TaylorSmith28/IQ_SDR/images/Schematics/SDR OPamp Power Supply.png

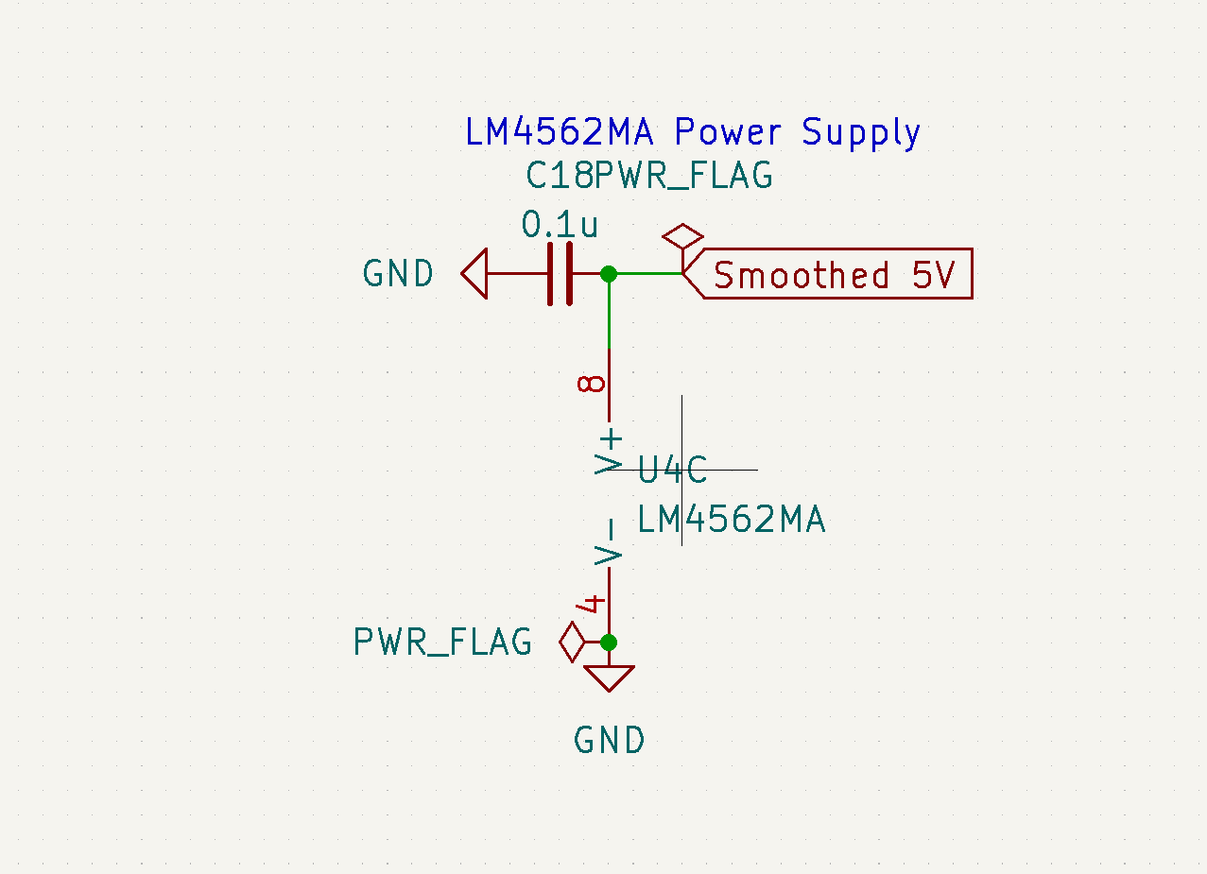
images/Schematics/SDR OPamp Power Supply.png
