TaylorSmith28/IQ_SDR/Kicad V6/Receiver Schematic.kicad_pcb

## KiCad design Kicad V6/Receiver Schematic.kicad_pcb (2022-06-07)

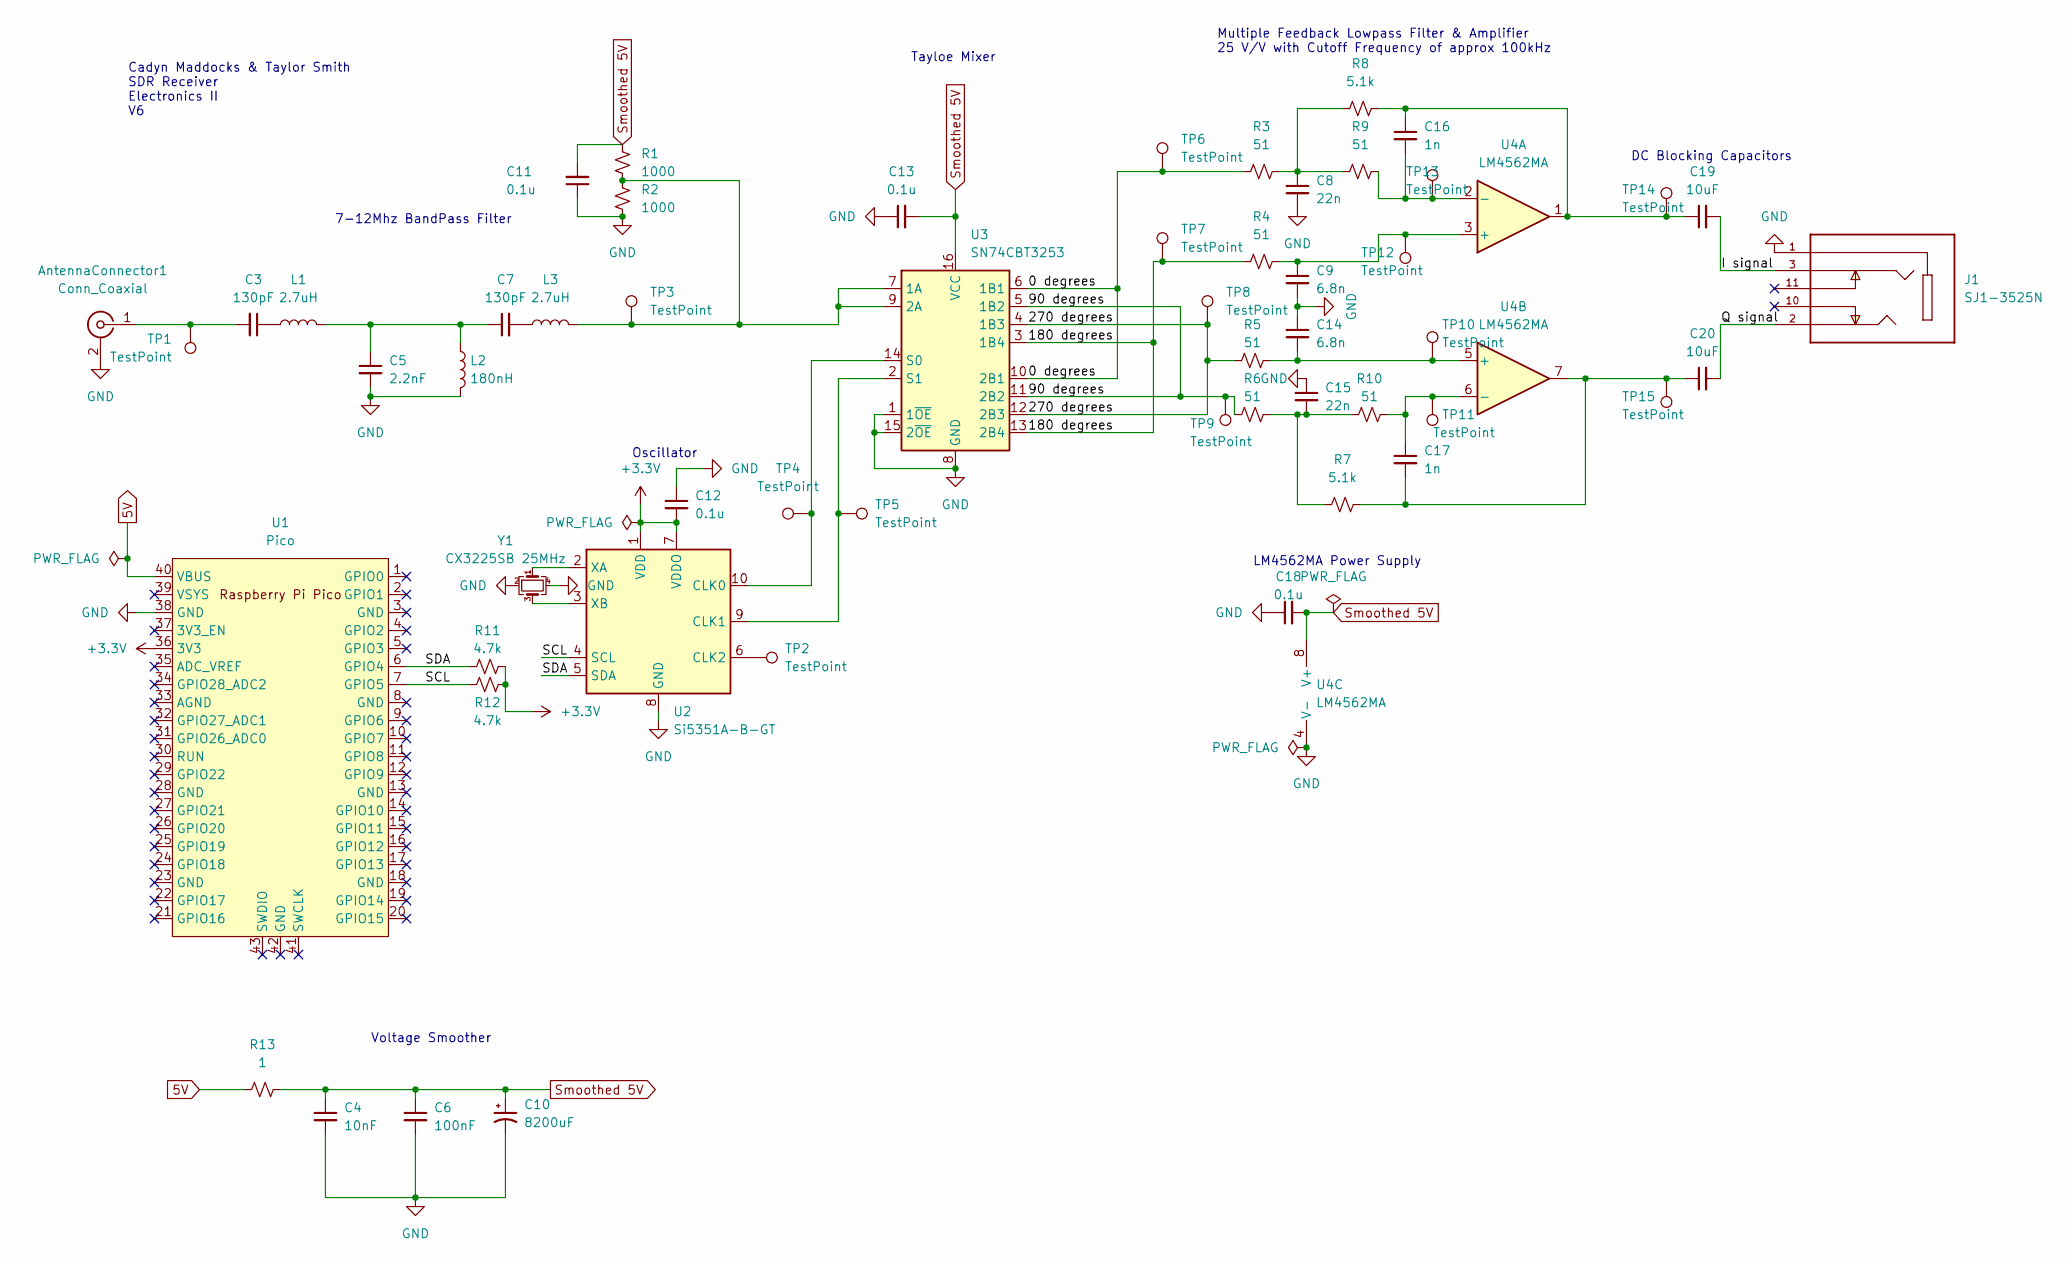
[picture p14: schematic Receiver Schematic.kicad_sch, SDR Receiver]

Parts:
AntennaConnector1: Conn_Coaxial; BNC_Amphenol_B6252HB-NPP3G-50_Horizontal
C3, C7: 130pF; C_0805_2012Metric
C4: 10nF; C_0805_2012Metric
C5: 2.2nF; C_0805_2012Metric
C6: 100nF; C_0805_2012Metric
C8, C15: 22n; C_0805_2012Metric
C9, C14: 6.8n; C_0805_2012Metric
C10: 8200uF; CP_Radial_D16.0mm_P7.50mm
C11, C12, C13, C18: 0.1u; C_0805_2012Metric
C16, C17: 1n; C_0805_2012Metric
C19, C20: 10uF; C_0805_2012Metric
J1: SJ1-3525N; CUI_SJ1-3525N; PARTREV 1.02
L1, L3: 2.7uH; L_Toroid_Vertical_L10.0mm_W5.0mm_P5.08mm
L2: 180nH; L_Toroid_Vertical_L10.0mm_W5.0mm_P5.08mm
R1, R2: 1000; R_0805_2012Metric
R3, R4, R5, R6, R9, R10: 51; R_0805_2012Metric
R7, R8: 5.1k; R_0805_2012Metric
R11, R12: 4.7k; R_0805_2012Metric
R13: 1; R_0805_2012Metric
TP1, TP2, TP3, TP4, TP5, TP6, TP7, TP8, TP9, TP10, TP11, TP12, TP13, TP14, TP15: TestPoint; TestPoint_THTPad_2.0x2.0mm_Drill1.0mm
U1: Pico; RPi_Pico_SMD_TH
U2: Si5351A-B-GT; MSOP-10_3x3mm_P0.5mm
U3: SN74CBT3253; SOIC-16_3.9x9.9mm_P1.27mm
U4: LM4562MA; SOIC-8_3.9x4.9mm_P1.27mm
Y1: CX3225SB 25MHz; Crystal_SMD_TXC_7M-4Pin_3.2x2.5mm

Connections:
5V: R13.1, U1.40 (VBUS)
+3V3: C12.2, R11.2, R12.2, U1.36 (3V3), U2.1 (VDD), U2.7 (VDDO)
/0 degrees: R3.1, TP6.1, U3.6 (1B1), U3.10 (2B1)
/90 degrees: R6.1, TP9.1, U3.5 (1B2), U3.11 (2B2)
/180 degrees: R4.1, TP7.1, U3.3 (1B4), U3.13 (2B4)
/270 degrees: R5.1, TP8.1, U3.4 (1B3), U3.12 (2B3)
/I signal: C19.2, J1.3
/Q signal: C20.2, J1.2
/SCL: R12.1, U1.7 (GPIO5), U2.4 (SCL)
/SDA: R11.1, U1.6 (GPIO4), U2.5 (SDA)
GND: AntennaConnector1.2 (Ext), C4.2, C5.2, C6.2, C8.2, C9.2, C10.2, C11.1, C12.1, C13.1, C14.1, C15.1, C18.1, J1.1, L2.2, R2.2, U1.38 (GND), U2.8 (GND), U3.1 (1~OE), U3.8 (GND), U3.15 (2~OE), U4.4 (V-), Y1.2, Y1.4
unnamed: AntennaConnector1.1 (In), C3.2, TP1.1
unnamed: C3.1, L1.1
unnamed: C5.1, C7.1, L1.2, L2.1
unnamed: C7.2, L3.1
unnamed: C8.1, R3.2, R8.1, R9.1
unnamed: C9.1, R4.2, TP12.1, U4.3 (+)
unnamed: C14.2, R5.2, TP10.1, U4.5 (+)
unnamed: C15.2, R6.2, R7.1, R10.1
unnamed: C16.1, C19.1, R8.2, TP14.1, U4.1
unnamed: C16.2, R9.2, TP13.1, U4.2 (-)
unnamed: C17.1, R10.2, TP11.1, U4.6 (-)
unnamed: C17.2, C20.1, R7.2, TP15.1, U4.7
unnamed: L3.2, R1.2, R2.1, TP3.1, U3.7 (1A), U3.9 (2A)
unnamed: TP2.1, U2.6 (CLK2)
unnamed: TP4.1, U2.10 (CLK0), U3.14 (S0)
unnamed: TP5.1, U2.9 (CLK1), U3.2 (S1)
unnamed: U2.2 (XA), Y1.1
unnamed: U2.3 (XB), Y1.3
Smoothed 5V: C4.1, C6.1, C10.1, C11.2, C13.2, C18.2, R1.1, R13.2, U3.16 (VCC), U4.8 (V+)

Notes on the sheet:
Multiple Feedback Lowpass Filter & Amplifier 25 V/V with Cutoff Frequency of approx 100kHz
Oscillator
LM4562MA Power Supply
Tayloe Mixer
7-12Mhz BandPass Filter
DC Blocking Capacitors
Voltage Smoother
Cadyn Maddocks & Taylor Smith SDR Receiver Electronics II V6

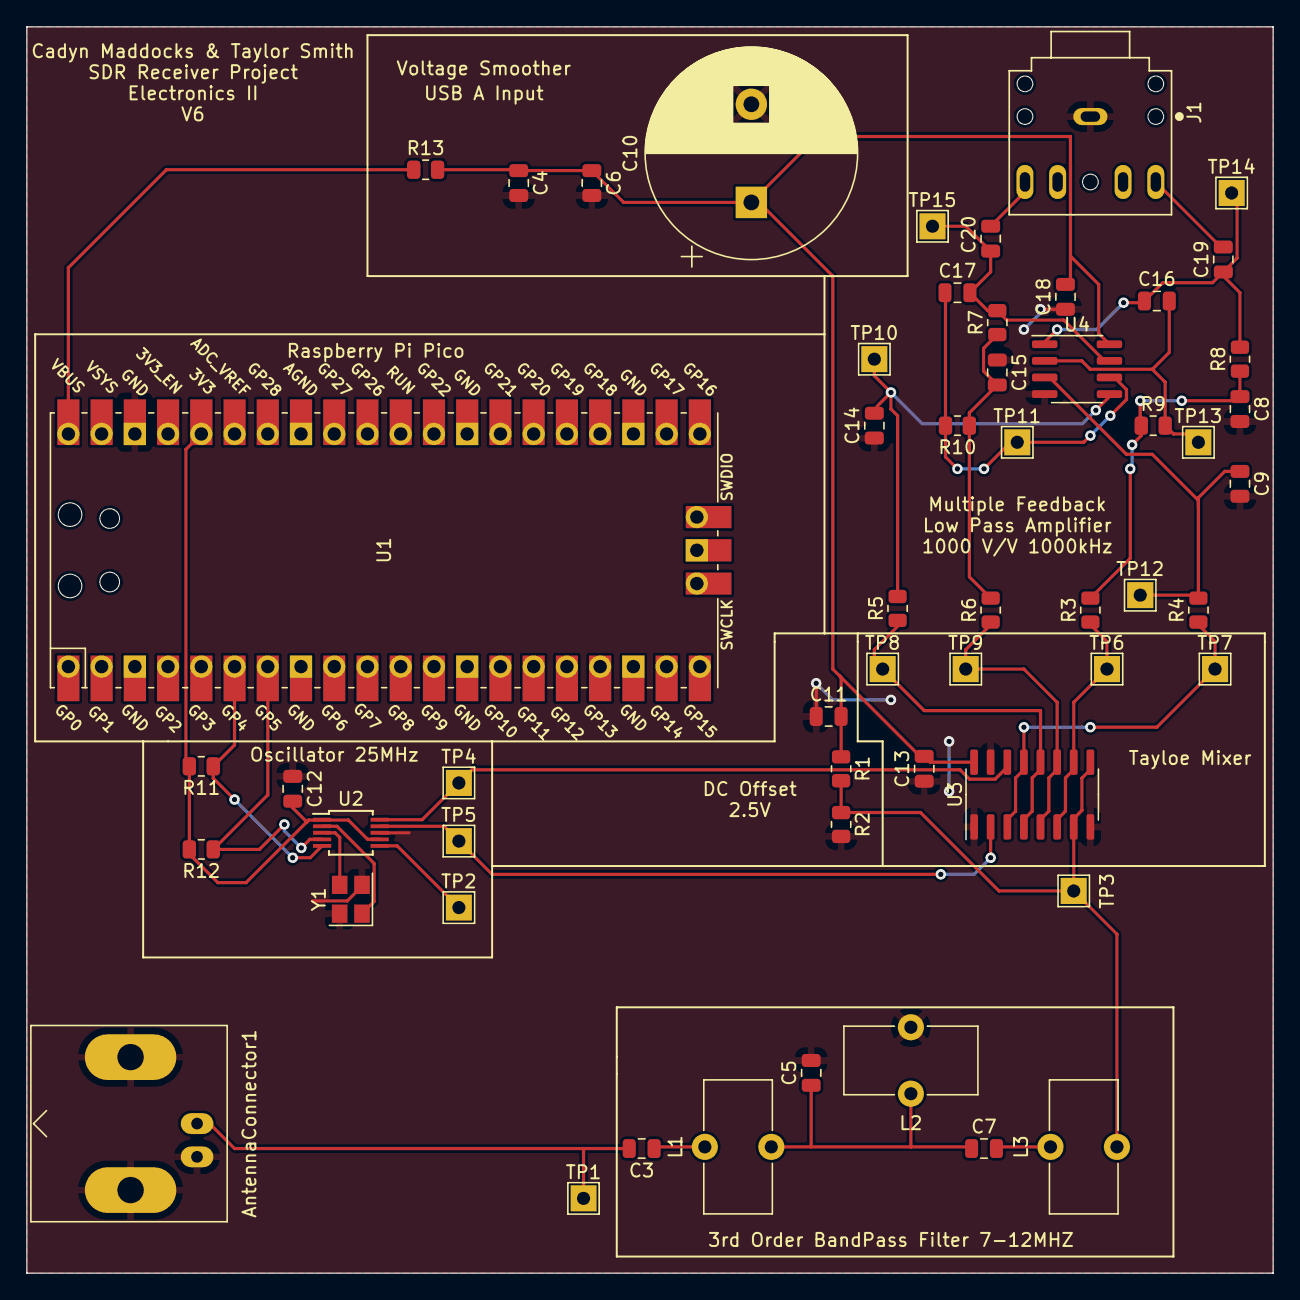
[picture p15: board Receiver Schematic.kicad_pcb from above]

Board: 2 copper layers, 95.3 x 95.2 mm, 56 parts (0 on the bottom side), 30 nets.
