TaylorSmith28/IQ_SDR/(commit log)

2022-06-07 Files from Project
    [Receiver Schematic-B_Cu.gbr, Receiver Schematic-B_Mask.gbr, Receiver Schematic-B_Paste.gbr, Receiver Schematic-B_Silkscreen.gbr, Receiver Schematic-Edge_Cuts.gbr, Receiver Schematic-F_Cu.gbr, Receiver Schematic-F_Mask.gbr, Receiver Schematic-F_Paste.gbr]
2022-06-07 Updated Files 2
    [Receiver Schematic-B_Cu.gbr, Receiver Schematic-B_Mask.gbr, Receiver Schematic-B_Paste.gbr, Receiver Schematic-B_Silkscreen.gbr, Receiver Schematic-Edge_Cuts.gbr, Receiver Schematic-F_Cu.gbr, Receiver Schematic-F_Mask.gbr, Receiver Schematic-F_Paste.gbr]
