TaylorSmith28/IQ_SDR/(notices)

Notices in the files:
Code/New_Quisk_Pico/New_Quisk_Pico.ino:
This program is free software: you can redistribute it and/or modify
it under the terms of the GNU General Public License as published by
the Free Software Foundation, either version 3 of the License, or
(at your option) any later version.
